WyraGit/ESP-32-Audio-IO/ESP32_audio_project/logo_png.h

#ifndef LOGO_PNG_H
#define LOGO_PNG_H

// Logo da Wyrá (só o pássaro) para as páginas web, servido pelo próprio
// aparelho em /logo.png. Fica na flash, então aparece também no modo de
// configuração, quando o celular está na rede do ESP32 e sem internet.
// Gerado a partir de logo.png: recortado, 330 px de largura, 128 cores.

const size_t logo_png_len = 12483;
const uint8_t logo_png[] PROGMEM = {
  0x89, 0x50, 0x4e, 0x47, 0x0d, 0x0a, 0x1a, 0x0a, 0x00, 0x00, 0x00, 0x0d, 0x49, 0x48, 0x44, 0x52,
  0x00, 0x00, 0x01, 0x4a, 0x00, 0x00, 0x00, 0xb7, 0x08, 0x03, 0x00, 0x00, 0x00, 0x43, 0x8c, 0xe7,
  0x44, 0x00, 0x00, 0x01, 0x80, 0x50, 0x4c, 0x54, 0x45, 0xa4, 0x60, 0x24, 0x21, 0x1a, 0x19, 0x20,
  0x1f, 0x21, 0x99, 0x96, 0x9e, 0xd5, 0x97, 0x2f, 0x64, 0x54, 0x53, 0x9a, 0x75, 0x60, 0x60, 0x56,
  0x5a, 0x1c, 0x1a, 0x1d, 0x22, 0x20, 0x22, 0x5d, 0x57, 0x5c, 0xd6, 0xa5, 0x4c, 0x5d, 0x59, 0x5e,
  0x5f, 0x45, 0x38, 0xc9, 0xb3, 0xa8, 0xda, 0xcc, 0xb5, 0x62, 0x2c, 0x0f, 0xe4, 0xcb, 0x5a, 0x9c,
  0x98, 0xa0, 0x42, 0x3d, 0x42, 0xa8, 0xb0, 0xc1, 0x98, 0x96, 0xa0, 0xa8, 0x86, 0x70, 0xc8, 0x75,
  0x1b, 0x3d, 0x3b, 0x42, 0xda, 0xde, 0xe0, 0x67, 0x12, 0x12, 0x9f, 0x9d, 0xa4, 0x9b, 0x62, 0x60,
  0x45, 0x3a, 0x3a, 0x90, 0x73, 0x6a, 0x44, 0x37, 0x37, 0x64, 0x64, 0x99, 0x1e, 0x1d, 0x62, 0x83,
  0x3b, 0x0d, 0x5e, 0x12, 0x5e, 0xa9, 0xa8, 0x5a, 0x84, 0x7d, 0x83, 0x93, 0x77, 0x6f, 0xb6, 0xbb,
  0xc7, 0x9f, 0x84, 0x7b, 0x3a, 0x39, 0x44, 0x78, 0x78, 0x85, 0x45, 0x3d, 0x45, 0x00, 0x00, 0xff,
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
  0xfa, 0xac, 0xef, 0xbe, 0x09, 0xb4, 0x20, 0x40, 0x6c, 0x06, 0xcc, 0x62, 0xb3, 0x18, 0x43, 0x0c,
  0xff, 0xfa, 0xfb, 0x3b, 0xe7, 0x5e, 0x09, 0xe1, 0x7d, 0x8b, 0xcd, 0x33, 0x13, 0xb5, 0x1f, 0x27,
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
};

#endif // LOGO_PNG_H
