WyraGit/ESP-32-Audio-IO/ESP32_audio_project/AudioI2SForESP32.h

#ifndef AUDIOI2SFORESP32_H
#define AUDIOI2SFORESP32_H

#include <driver/i2s.h>

#define VERSAO_LIB 1.0

// Master clock (MCLK) do PCM1808. O ESP32 só consegue tirar o MCLK pelos
// GPIO 0, 1 ou 3; aqui vai pelo GPIO 3 (RX0).
#define I2S_RX_MCLK   3

// ============================================================
// FUNÇÕES DE INICIALIZAÇÃO DE ÁUDIO I2S
// ============================================================

void initI2S_TX() {
  i2s_config_t cfg = {
    .mode                 = (i2s_mode_t)(I2S_MODE_MASTER | I2S_MODE_TX),
    .sample_rate          = SAMPLE_RATE,
    .bits_per_sample      = I2S_BITS_PER_SAMPLE_16BIT,
    .channel_format       = I2S_CHANNEL_FMT_RIGHT_LEFT,
    .communication_format = (i2s_comm_format_t)(I2S_COMM_FORMAT_I2S | I2S_COMM_FORMAT_I2S_MSB),
    .intr_alloc_flags     = ESP_INTR_FLAG_LEVEL1,
    .dma_buf_count        = 8,
    .dma_buf_len          = 64,
    .use_apll             = true,
    .tx_desc_auto_clear   = true,
    .fixed_mclk           = 0
  };
  i2s_driver_install(I2S_NUM_0, &cfg, 0, NULL);

  // O PCM5102A gera o próprio clock (pino SCK no GND), então o I2S0 não
  // tira MCLK em pino nenhum. Sem o campo explícito ele valeria 0 e o
  // driver poria o MCLK no GPIO 0, que é o botão BOOT.
  i2s_pin_config_t pins = {
    .mck_io_num   = I2S_PIN_NO_CHANGE,
    .bck_io_num   = I2S_TX_BCK,
    .ws_io_num    = I2S_TX_WS,
    .data_out_num = I2S_TX_DOUT,
    .data_in_num  = I2S_PIN_NO_CHANGE
  };
  i2s_set_pin(I2S_NUM_0, &pins);
  i2s_zero_dma_buffer(I2S_NUM_0);
}

void initI2S_RX() {
  i2s_config_t cfg = {
    .mode                 = (i2s_mode_t)(I2S_MODE_MASTER | I2S_MODE_RX),
    .sample_rate          = SAMPLE_RATE,
    .bits_per_sample      = I2S_BITS_PER_SAMPLE_16BIT,
    .channel_format       = I2S_CHANNEL_FMT_RIGHT_LEFT,
    .communication_format = (i2s_comm_format_t)(I2S_COMM_FORMAT_I2S | I2S_COMM_FORMAT_I2S_MSB),
    .intr_alloc_flags     = ESP_INTR_FLAG_LEVEL1,
    .dma_buf_count        = 8,
    .dma_buf_len          = 64,
    .use_apll             = true,
    .tx_desc_auto_clear   = false,
    .fixed_mclk           = 0
  };
  i2s_driver_install(I2S_NUM_1, &cfg, 0, NULL);

  // O PCM1808 precisa de MCLK (256 x 44,1 kHz) para gerar amostras.
  // O próprio driver roteia o MCLK do I2S1 para o GPIO 3 (função CLK_OUT2).
  i2s_pin_config_t pins = {
    .mck_io_num   = I2S_RX_MCLK,
    .bck_io_num   = I2S_RX_BCK,
    .ws_io_num    = I2S_RX_WS,
    .data_out_num = I2S_PIN_NO_CHANGE,
    .data_in_num  = I2S_RX_DIN
  };
  i2s_set_pin(I2S_NUM_1, &pins);
}

#endif // AUDIOI2SFORESP32_H
