WyraGit/ESP-32-Audio-IO/(commit log)

2026-11-04 Rewrite README in English for v2
    Document the three switch modes (TCP server, Bluetooth A2DP, aux
    pass-through), full wiring including the PCM1808 master clock on GPIO 3
    and the switch on GPIO 34/35 with external pull-ups, build steps for the
    ESP32 core 2.x, the TCP audio protocol, tested status and troubleshooting.
2026-11-04 Keep saved Wi-Fi, run Bluetooth and Aux without a network, English UI
    - Stop erasing the saved Wi-Fi when it doesn't answer at boot: open the
    setup network and retry the saved one every 30 s, pausing while
    someone is using the setup page; restart once it connects.
    - Only the TCP server mode needs Wi-Fi. Bluetooth starts with Wi-Fi off,
    and Aux joins a saved network in the background for the dashboard.
    - Translate the web pages and OLED messages to English.
    - Add a time-zone choice to the setup page and use pool.ntp.org.
    - Rebrand to Wyrá: license header now matches the proprietary LICENSE,
    OLED boot logo shows the bird plus "Wyrá", and the web logo is served
    from flash (logo_png.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
    [AudioI2SForESP32.h, ESP32_audio_project.ino, html_pages.h, logo_png.h]
2026-11-04 Add a Python client and a stand-in hub for the TCP server mode
    - client/wyra_audio_client.py: listen, record, send-pc, send-file and tone
    commands, with live level meters, a jitter buffer and automatic reconnect
    - client/fake_hub.py: emulates an Audio Hub on this computer, to test
    clients without hardware
    - client/requirements.txt: soundcard and numpy, needed only by listen and
    send-pc; the other commands use the standard library alone
    - README: document the client and the stand-in hub
